ricardodeazambuja/TEXvid/README.md

# TEXvid - A simple composite video character generator  
I've created this for my final project, just before I graduated in Electrical Engineering. The system uses a PIC16F428 and all the code was done directly in assembly. Nowadays I would not bother to program in assembly :)    
It worked connected through the serial port (2400-8N1). Each command started with a '@' followed by the line number (1 or 2) and the text (maximum 12 characters).  
Example: @1HELLO, WORLD!
## Diagram Showing How it worked
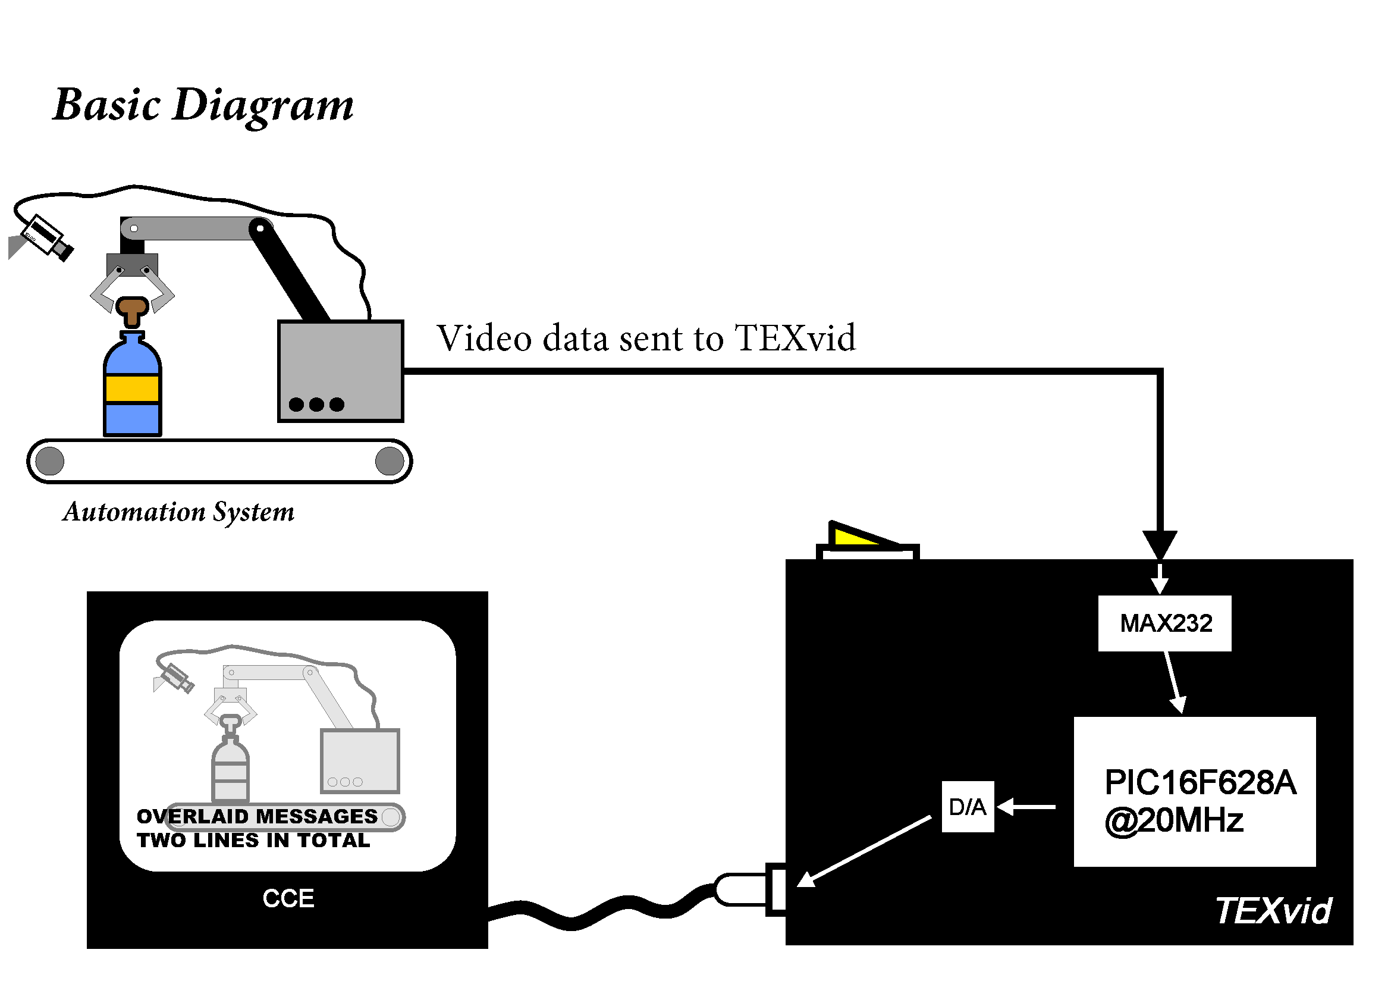
[picture p1: imgs/howitworks_diag.png]
TEXvid - How it works
  
## PCB
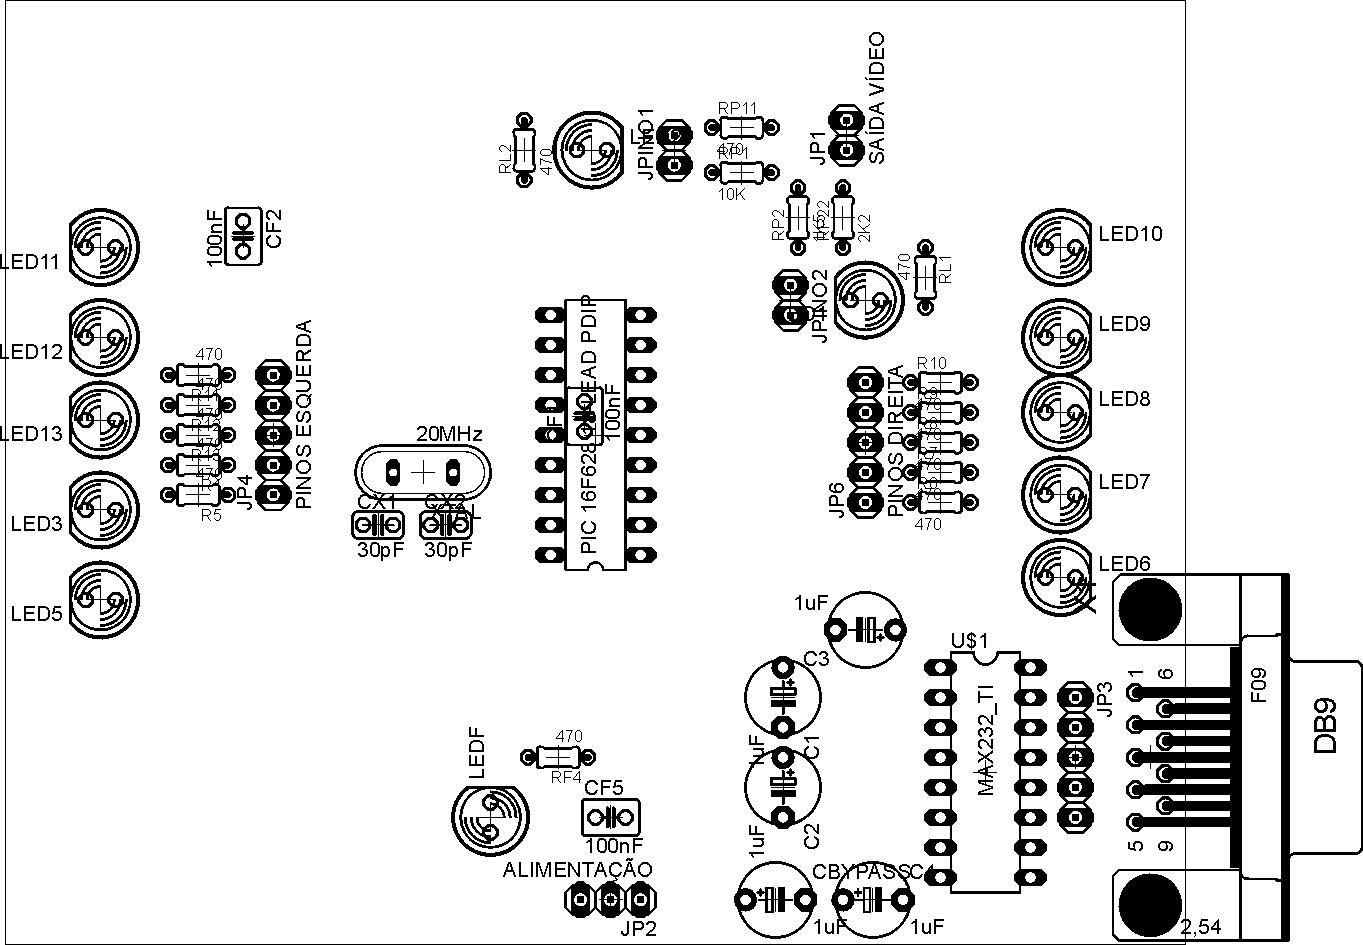
[picture p2: imgs/TEXvid_pcb_parts.png]
PCB - parts
  
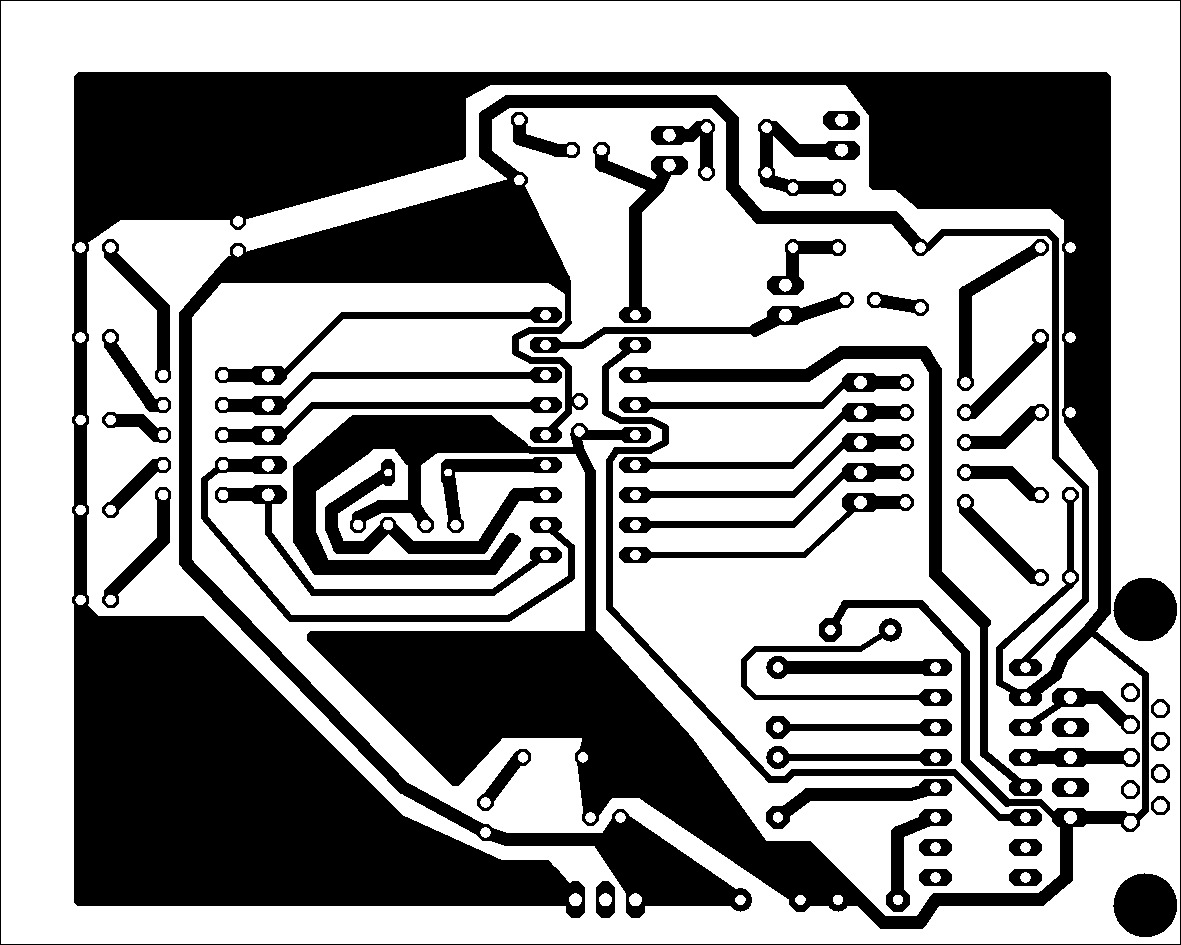
[picture p3: imgs/TEXvid_pcb_traces.png]
PCB - traces
  
## The only photograph I could find from it
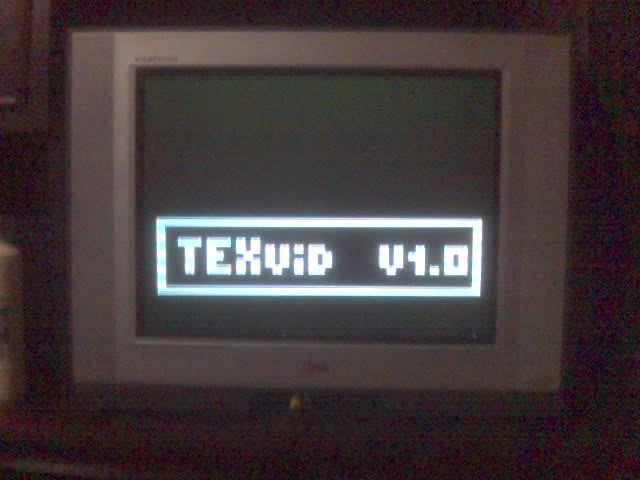
[picture p4: imgs/texvid_working.jpeg]
TEXvid - live!

## Example of how the characters were created
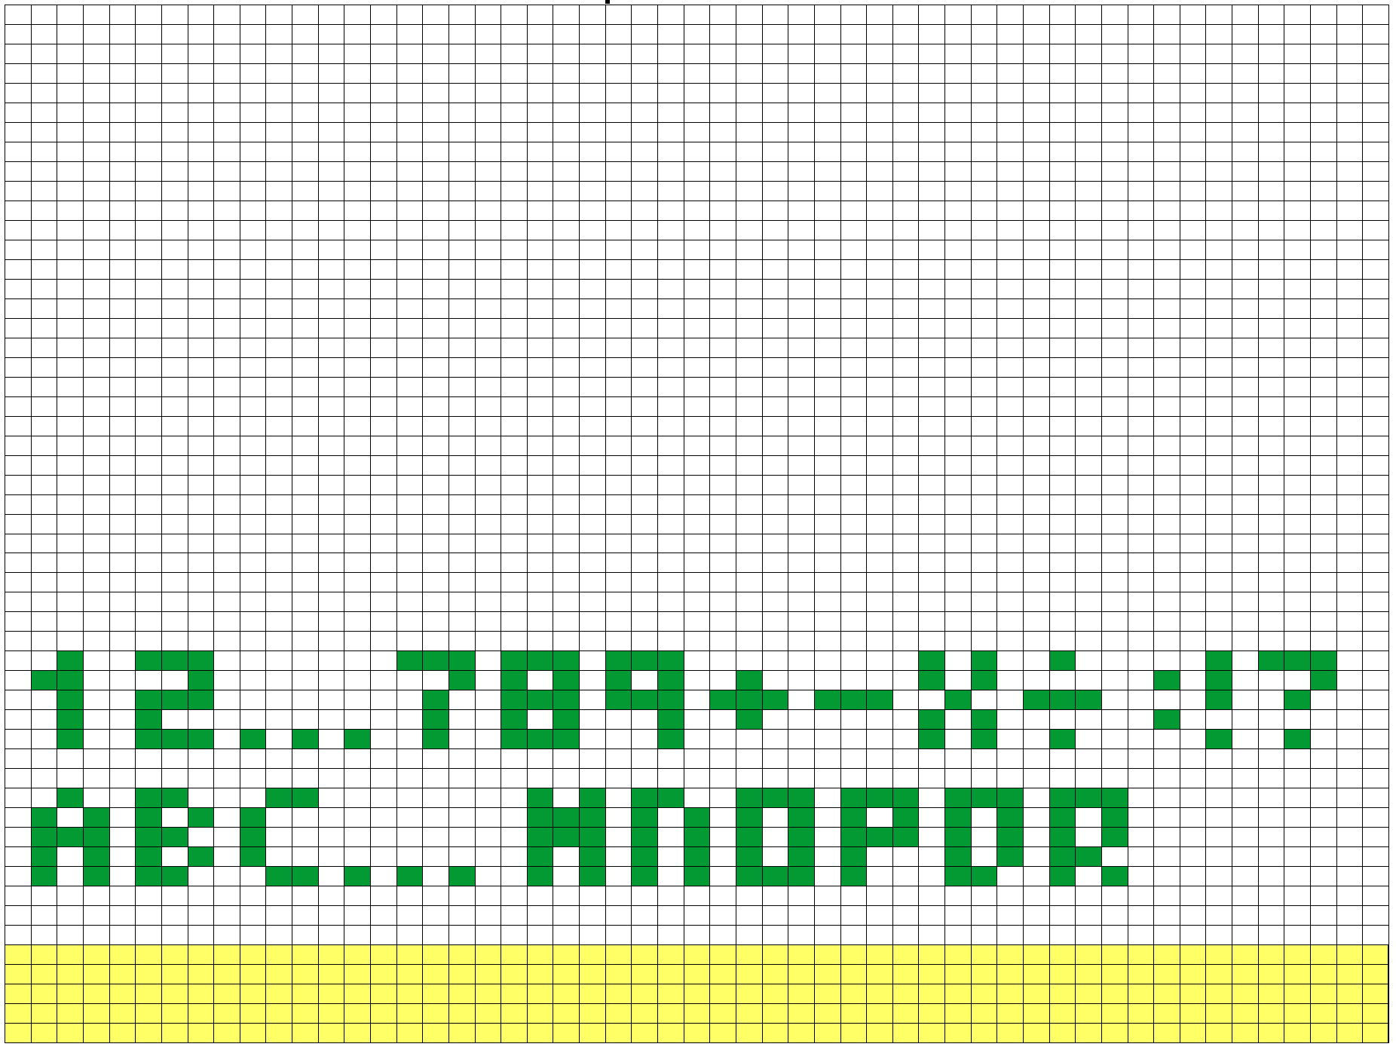
[picture p5: imgs/texvid_example.png]


http://ricardodeazambuja.com/
